hypermaq/Panthyr_Electronics/Design/_Hypermaq Topside/V0.4/2020-06-11 10_59_16-Autodesk Inventor Professional 2018.png

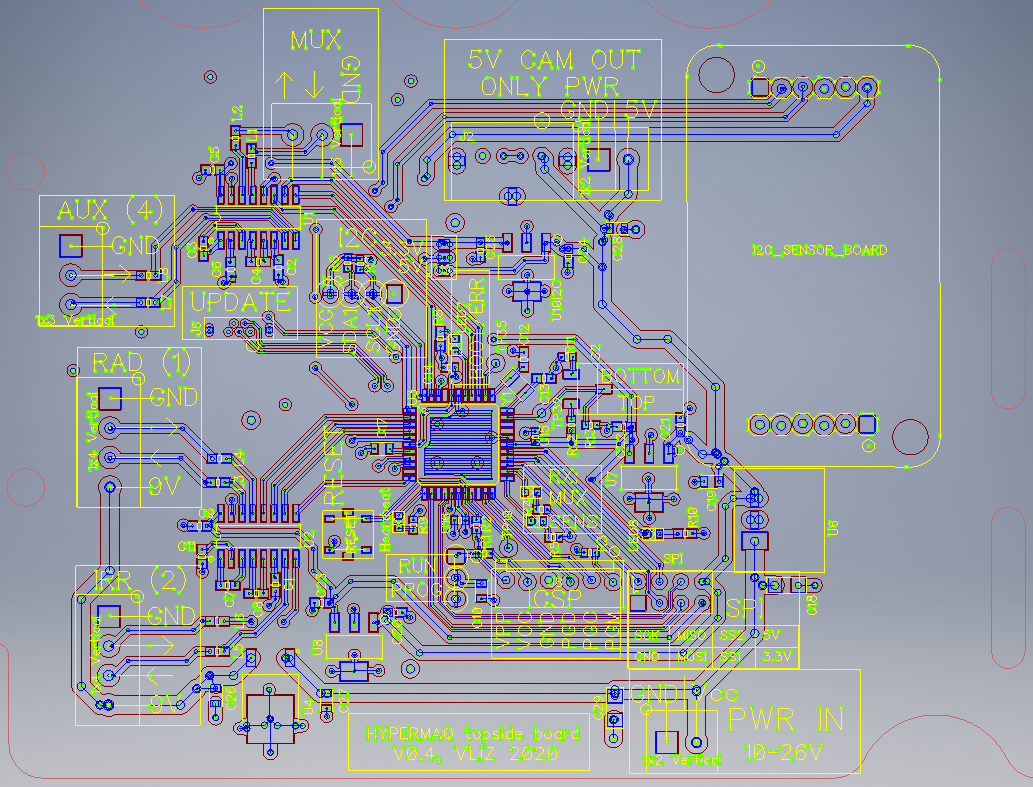
Design/_Hypermaq Topside/V0.4/2020-06-11 10_59_16-Autodesk Inventor Professional 2018.png
