hypermaq/Panthyr_Electronics/Design/_Hypermaq Topside/V0.4/2020-06-11 11_46_50-PCB Layout - [E__Projects_Hypermaq_Electronics_Design__Hypermaq Topside_V0.4_Top.png

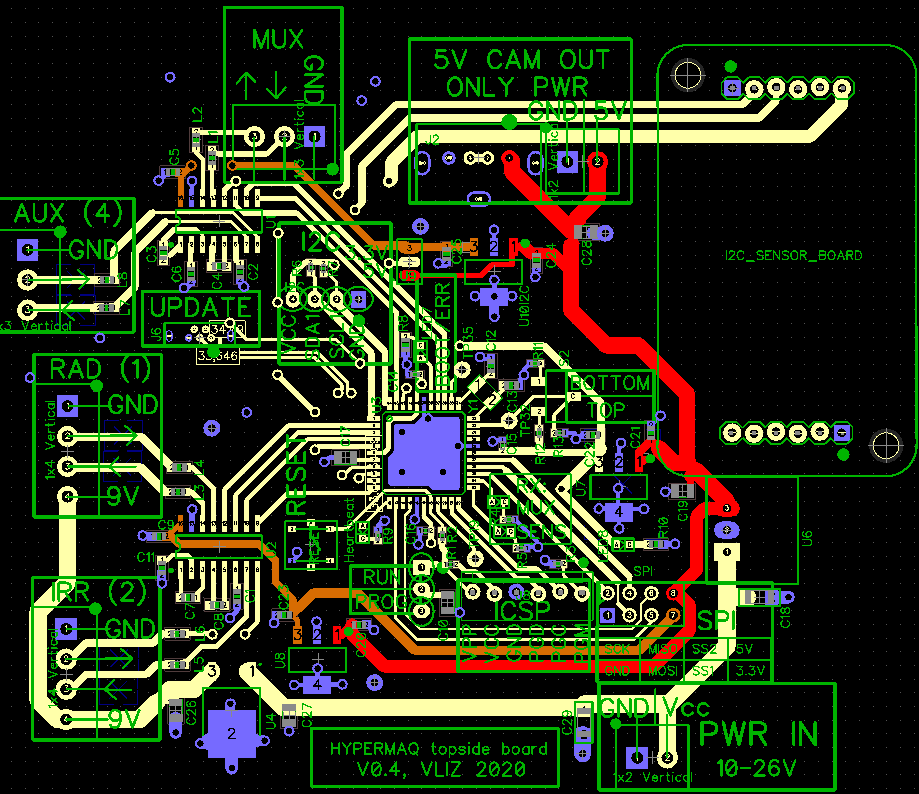
Design/_Hypermaq Topside/V0.4/2020-06-11 11_46_50-PCB Layout - [E__Projects_Hypermaq_Electronics_Design__Hypermaq Topside_V0.4_Top.png
