hypermaq/Panthyr_Electronics/Design/_Hypermaq Topside/V0.4/2020-06-11 14_29_41-PCB Layout - [E__Projects_Hypermaq_Electronics_Design__Hypermaq Bottomside_V0.3_.png

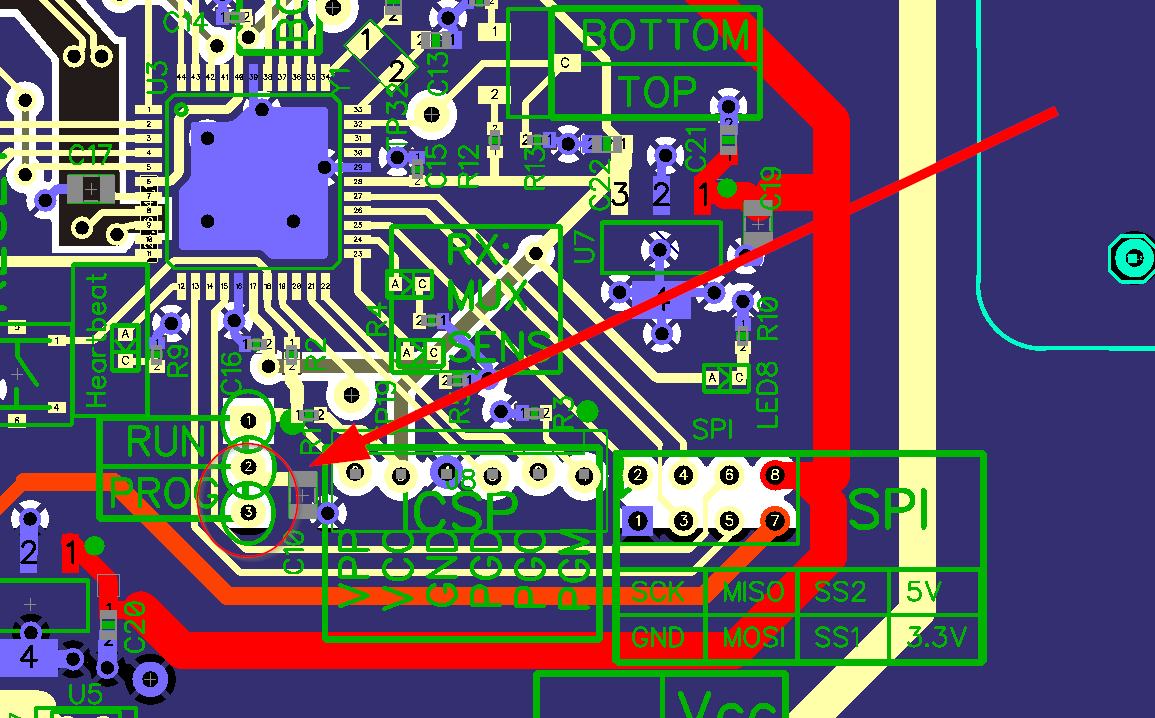
Design/_Hypermaq Topside/V0.4/2020-06-11 14_29_41-PCB Layout - [E__Projects_Hypermaq_Electronics_Design__Hypermaq Bottomside_V0.3_.png
