hypermaq/Panthyr_Electronics/Design/_Hypermaq Topside/V0.4/Topside v0.4d2.dxf

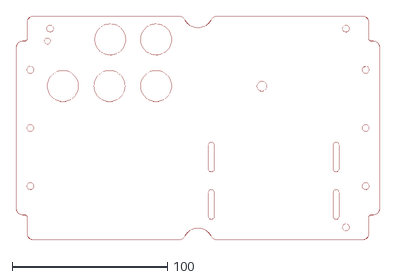
[picture p4: CAD file, 2020-07-08]
Design/_Hypermaq Topside/V0.4/Topside v0.4d2.dxf
234.1 x 144.1
