hypermaq/Panthyr_Electronics/(list of files, cad)

Other CAD files:
Design/_Hypermaq I2C sensor board/Board layout dimensions.dwg
