hypermaq/Panthyr_Electronics/Design/_Hypermaq I2C sensor board/Board layout dimensions.pdf

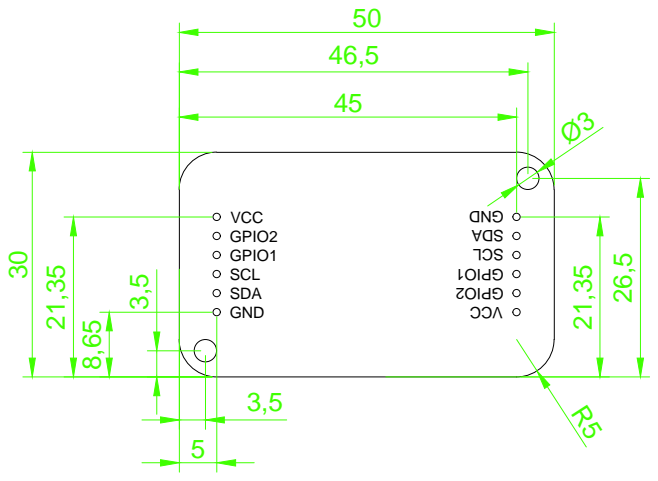
[picture p5: page 1]
3,5 VCC
