hypermaq/Panthyr_Electronics/(list of files, drawings)

Other design files:
Design/_Hypermaq Bottomside/V0.1/Hypermaq Bottomside v0.1.dip
Design/_Hypermaq Bottomside/V0.1/Topside v0.1.dch
Design/_Hypermaq Bottomside/V0.2/Bottomside v0.2.dch
Design/_Hypermaq Bottomside/V0.2/Hypermaq Bottomside v0.2.dip
Design/_Hypermaq Bottomside/V0.3/Bottomside v0.3.dch
Design/_Hypermaq Bottomside/V0.3/Hypermaq Bottomside v0.3.dip
Design/_Hypermaq communication board/V0.1/Communication board Update michiel.dch
Design/_Hypermaq communication board/V0.1/Communication board Update michiel.dip
Design/_Hypermaq communication board/V0.2/Communication board v02.dch
Design/_Hypermaq communication board/V0.2/Communication board v02.dip
Design/_Hypermaq communication board/V0.3/Communication board v03.dch
Design/_Hypermaq communication board/V0.3/Communication board v03.dip
Design/_Hypermaq I2C sensor board/v0.1/Hypermaq I2C sensor board v0.1.dch
Design/_Hypermaq I2C sensor board/v0.1/Hypermaq I2C sensor board v0.1.dip
Design/_Hypermaq power board/V0.1/Power board Update michiel.dch
Design/_Hypermaq power board/V0.1/Power board Update Michiel.dip
Design/_Hypermaq power board/V0.2/Power board v02.dch
Design/_Hypermaq power board/V0.2/Power board v02.dip
Design/_Hypermaq power board/v0.3/Power board v03.1.dip
Design/_Hypermaq power board/v0.3/Power board v03.dch
Design/_Hypermaq power board/v0.4/Power board v04.dch
Design/_Hypermaq power board/v0.4/Power board v04.dip
Design/_Hypermaq power board/v0.5/Power board v05.dch
Design/_Hypermaq power board/v0.5/Power board v05.dip
Design/_Hypermaq power board/v0.6/Power board v0.6.dip
Design/_Hypermaq power board/v0.6/Power board v0.dip
Design/_Hypermaq power board/v0.6/Power board v06.dch
Design/_Hypermaq power board/v0.7/diptrace 3 Power board v0.7.dch
Design/_Hypermaq power board/v0.7/Power board v0.7.dch
Design/_Hypermaq power board/v0.7/Power board v0.7.dip
Design/_Hypermaq Topside/V0.1/Topside v0.1.dch
Design/_Hypermaq Topside/V0.1/Topside v0.dip
Design/_Hypermaq Topside/V0.2/Topside v0.2 Enclosure.dch
Design/_Hypermaq Topside/V0.2/Topside v0.2.dch
Design/_Hypermaq Topside/V0.2/Topside v0.2.dip
Design/_Hypermaq Topside/V0.2/Topside v0.2b.dip
Design/_Hypermaq Topside/V0.3/Topside v0.3 Enclosure.dch
Design/_Hypermaq Topside/V0.3/Topside v0.3.dip
Design/_Hypermaq Topside/V0.4/Topside v0.4.dch
Design/_Hypermaq Topside/V0.4/Topside v0.4.dip
Design/_Hypermaq Topside/V0.4/Topside v0.4b.dip
Design/_Hypermaq Topside/V0.4/Topside v0.4c.dip
Design/_Hypermaq Topside/V0.4/Topside v0.4d.dip
