hypermaq/Panthyr_Electronics/(commit log)

2018-05-22 Initial Commit, PCB at V0.2
    [BOM.xlsx, BeagleBone_LaunchPad_draft3.dch, BeagleBone_LaunchPad_draft3_0.dip, Communication board Update michiel.dch, Communication board Update michiel.dip, Communication board v02.dch, Communication board v02.dip, Communication board.dch]
2018-06-20 Added resistors to TTYO1 and TTYO2 (leakage to ground through serial lines) Improved routing and groundplane coverage Added connector for 4 GPIO pins on communications board
    [Communication board v02.dch, Communication board v02.dip, Power board v02.dch, Power board v02.dip]
2018-06-20 Updated BOM (added components that weren't in the list, corrected values for fuses, ferrite bead)
    [BOM.xlsx]
2019-01-21 Update for v0.2
    [Adapter board.dch, Adapter board.dip, BOM.xlsx, Communication board v02.dip, Power board v02.dch, Power board v02.dip, Power distribution v0.1.dch, Power distribution v0.1.dip]
2019-06-06 v0.1 of adapter board v0.1 of power distribution v0.3 of hypermaq power board
    [Adapter board.dch, Adapter board.dip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]
2019-06-12 - v0.3
    [Power board v03.1.dip, Power board v03.dch]
2019-08-14 - initial commit to github, removed datasheets and bbb directory
    [BOM.xlsx, BeagleBone_LaunchPad_draft3.dch, BeagleBone_LaunchPad_draft3_0.dip, Communication board v02.dch, Communication board v02.dip, Power board v03.1.dip, Power board v03.dch, Shopping Cart most included.csv]
2020-01-16 Update NXP AN3461 Tilt Sensing Using a Three-Axis Accelerometer.pdf, NXP AN4246 Calibrating an eCompass in the presence of hard and soft iron interference.pdf, and 61 more files...
    [Adapter board.dch, Adapter board.dip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]
2020-07-08 - Designs as sent to myProto for replication
    [Adapter board.dch, Adapter board.dip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]
